CEAZAMet/CEAZA-Snow-Scale/01.Hardware/01.CAD_files/pcb_layout.pdf

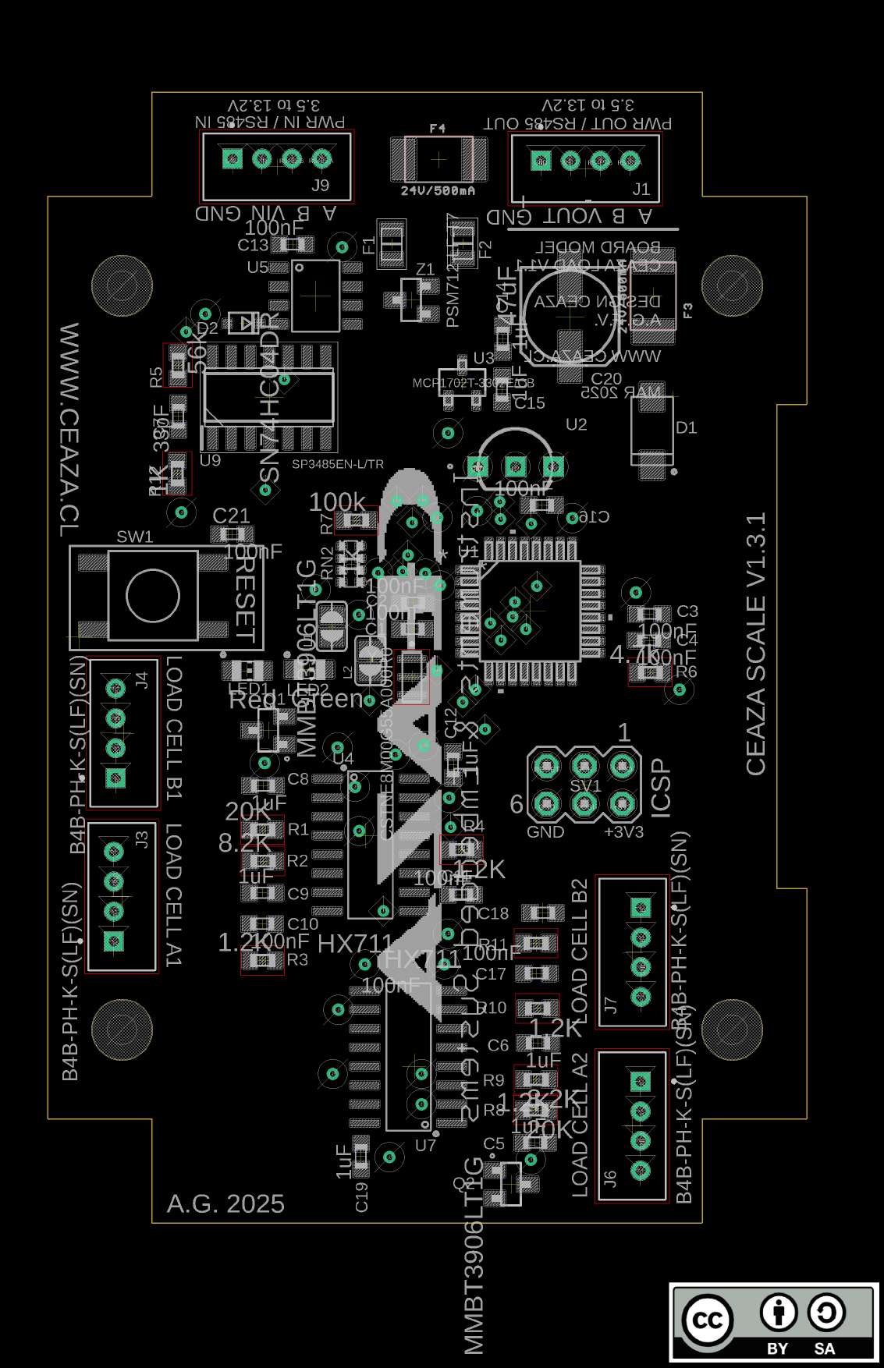
[picture p4: page 1]
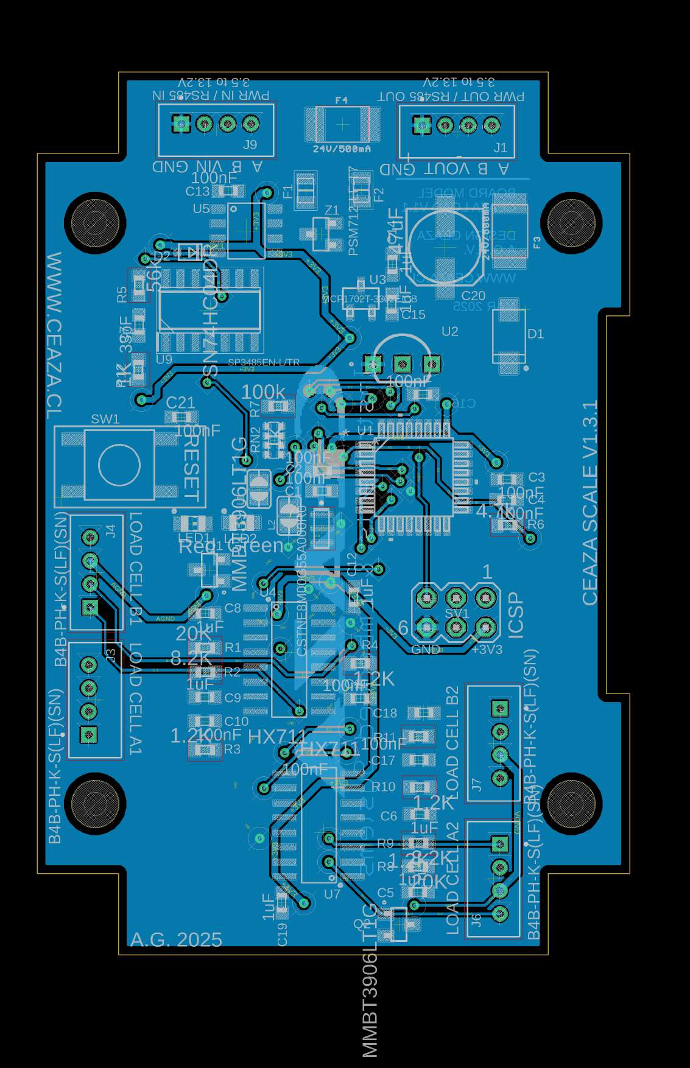
[picture p5: page 2]
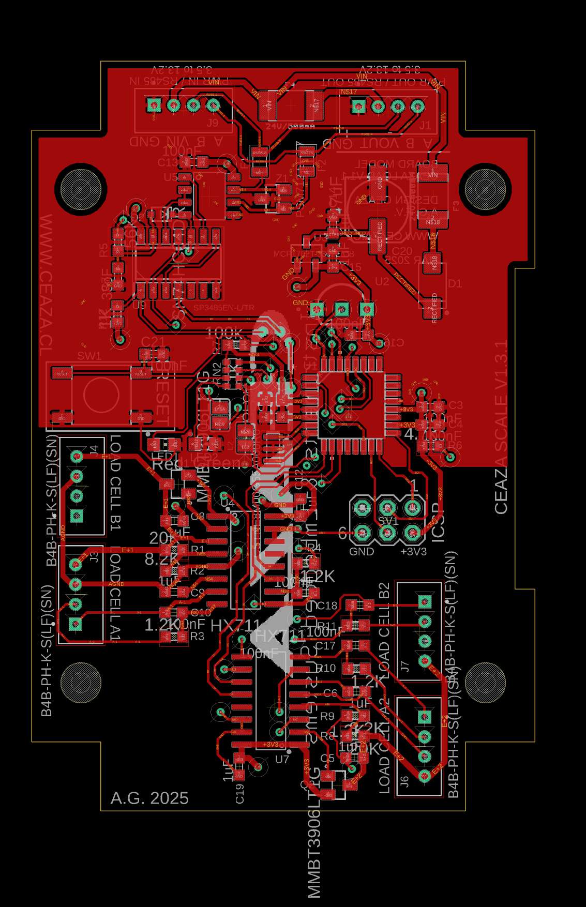
[picture p6: page 3]
