CEAZAMet/CEAZA-Snow-Scale/01.Hardware/01.CAD_files/schematic_snow_scale.pdf

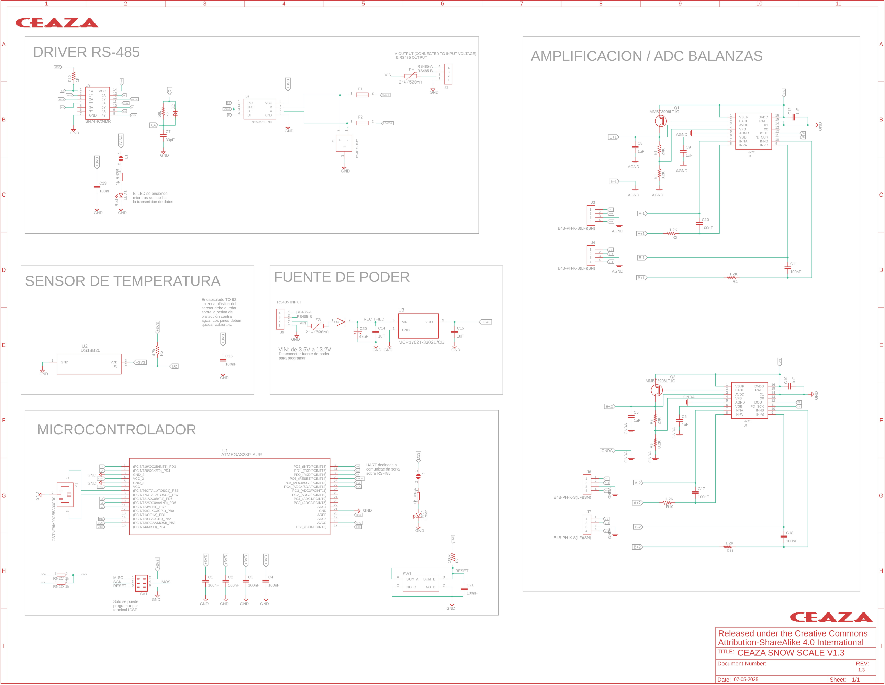
[picture p7: page 1]
