CEAZAMet/CEAZA-Snow-Scale/03.Photos/CEAZA_SNOWSCALE_V1.3_BOTTOM.jpeg

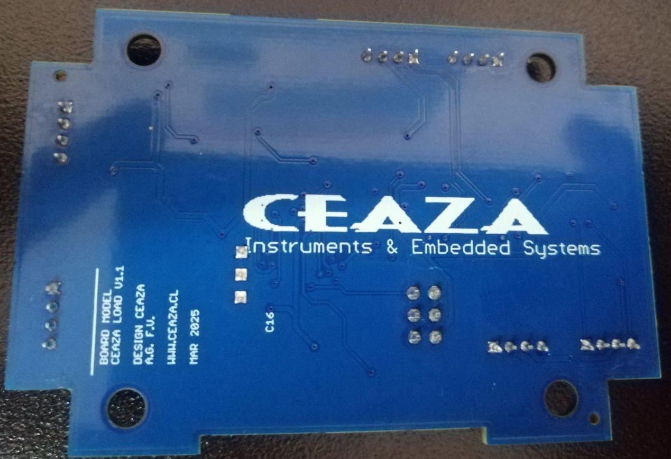
03.Photos/CEAZA_SNOWSCALE_V1.3_BOTTOM.jpeg
