CEAZAMet/CEAZA-Snow-Scale/01.Hardware/02.BOM/BOM_CEAZA_SNOW_SCALE_V1.3.xls

Comment | Designator | Footprint
LITTELFUSE - 0805L010/24YR - Resettable | F1, F2 | FUSC2114X100N
PH Series 4 Position 2 mm Pitch | J1, J9, J3, J4, J6, J7 | JST_B4B-PH-K-S(LF)(SN)
DIODE 75V Independent Type 1.25V@150mA | D2 | SOD323-R
PIN HEADER | SV1 | MA03-2
U1 | SW1 | SW_KH-6X6X5H-STM
1.2K R-US 0603 | R3, R4, R10, R11 | R0603
Multilayer Ceramic Capacitors MLCC - SMD/SMT 100nF 50V 0603 RoHS | C1,C2, C3, C4, C10, C11, C13, C16, C17, C18,C21 | C0603K
1k | R12 | R0603
Resistor Networks & Arrays 1KOhms ±5% 1/16W 0603_x4 RoHS | RN2 | 0603-ARV
CAPACITOR, European symbol | C5, C6, C8, C9, C12, C14, C15, C19 | C0603K
20K | R1, R8 | R0603
Resettable Fuse PTC 24V 500mA | F3, F4 | 1812
33pF | C7 | C0603K
4K7 | R6 | R0603
47uF Decoupling Capacitor | C20 | 153CLV-0605
56k | R5 | R0603
8k2 | R2, R9 | R0603
ATMEL & AVR TQFP-32_7x7x08P RoHS | U1 | 32A
8MHz Ceramic Resonator Built in | Y1 | OSC_CSTNE8M00G55A000R0
DS18B20 | U2 | 21-0248A_MXM
GREEN LEDCHIP-LED0805 | LED2 | CHIP-LED0805
Analog To Digital Converters (ADCs) 24 | U4, U7 | HX711
250 mA Low Quiescent Current LD | U3 | SOT95P255X145-3N
MMBT3906LT1G | Q1, Q2 | SOT23
PSM712-LF-T7 | Z1 | SOT23
RED LEDCHIP-LED0805 | LED1 | CHIP-LED0805
SMA-SS34 | D1 | SMA-SS34
SN74HC04DR, Hex Inverter 5.2mA | U9 | SOIC127P600X175-14N
1.75mm Texas Instruments SN74HC04DR | U5 | SP3485EN-L/TR
100K | R7 | R0603
