CEAZAMet/CEAZA-Snow-Scale/05.Validation_Tests/README.md

# Portable Snow Scale Results

This repository contains the documentation associated with the development and validation of the **Portable Snow Scale**, a project led by **CEAZA** and funded by the **National Agency for Research and Development (ANID)** through the IDEA and R&D programs (Projects **ID22I10074** and **R19F10002**) between 2020 & 2025.

## Contents

- 📊 Experimental test data
- 🧪 Analysis and validation code
- 📄 Technical documentation
- 🖼️ Photos and videos

## Structure

```
/data      - Raw and processed data files  
/code      - Scripts for data analysis and validation  
/docs      - Project documentation and hardware description  
/media     - Visual materials (photos, videos)  
```

## Related Links

- 🔗 Project Website: [https://rednival.ceazamet.cl/](https://rednival.ceazamet.cl/)
- 🔗 Experimental Network (Snow Nodes): [https://www.ceazamet.cl/index.php?pag=mod_mapa&p_cod=nodosnieve](https://www.ceazamet.cl/index.php?pag=mod_mapa&p_cod=nodosnieve)

## License

This project is licensed under the **GNU General Public License v3.0 (GPL-3.0)**.

You may freely use, modify, and distribute this work, provided that any derivative works are also licensed under GPL-3.0 or a compatible version.

See the [`LICENSE`](./LICENSE) file for the full license text, or visit:  
https://www.gnu.org/licenses/gpl-3.0.html
