CEAZAMet/CEAZA-Snow-Scale/05.Validation_Tests/data/README.md

# /data

This folder contains experimental datasets used for validation and analysis of the Portable Snow Scale.
