CEAZAMet/CEAZA-Snow-Scale/05.Validation_Tests/data/BR_IOT.csv

id,I9B8C,dt,2023-03-30T16:15:12Z,vin,13.68,at,24.50,sh,258,sw,0.20,swt,35.44,C,46539
id,I9B8C,dt,2023-03-30T16:25:20Z,vin,13.67,at,25.19,sh,261,sw,0.15,swt,39.81,C,1132
id,I9B8C,dt,2023-03-30T16:35:28Z,vin,13.66,at,25.06,sh,259,sw,0.18,swt,42.94,C,39516
id,I9B8C,dt,2023-03-30T16:45:36Z,vin,13.68,at,25.00,sh,258,sw,0.21,swt,44.56,C,44070
id,I9B8C,dt,2023-03-30T16:55:44Z,vin,13.67,at,24.88,sh,258,sw,0.22,swt,45.06,C,3022
id,I9B8C,dt,2023-03-30T17:16:00Z,vin,13.68,at,22.94,sh,259,sw,0.05,swt,41.69,C,25331
id,I9B8C,dt,2023-03-30T17:26:08Z,vin,13.67,at,22.00,sh,259,sw,-0.11,swt,38.56,C,50198
id,I9B8C,dt,2023-03-30T17:36:16Z,vin,13.68,at,21.75,sh,259,sw,-0.21,swt,35.19,C,14684
id,I9B8C,dt,2023-03-30T17:46:23Z,vin,13.63,at,20.69,sh,259,sw,-0.27,swt,32.56,C,36859
id,I9B8C,dt,2023-03-30T17:56:31Z,vin,13.60,at,20.19,sh,258,sw,-0.31,swt,30.63,C,20906
id,I9B8C,dt,2023-03-30T18:06:39Z,vin,13.60,at,18.56,sh,259,sw,-0.33,swt,29.31,C,4402
id,I9B8C,dt,2023-03-30T18:16:47Z,vin,13.61,at,18.88,sh,259,sw,-0.33,swt,28.50,C,49422
id,I9B8C,dt,2023-03-30T18:37:02Z,vin,13.59,at,18.38,sh,258,sw,-0.34,swt,27.44,C,65097
id,I9B8C,dt,2023-03-30T18:47:10Z,vin,13.57,at,18.38,sh,259,sw,-0.34,swt,27.00,C,1773
id,I9B8C,dt,2023-03-30T18:57:18Z,vin,13.60,at,18.38,sh,260,sw,-0.34,swt,26.56,C,61443
id,I9B8C,dt,2023-03-30T19:07:26Z,vin,13.57,at,18.81,sh,259,sw,-0.34,swt,26.19,C,35102
id,I9B8C,dt,2023-03-30T19:17:33Z,vin,13.55,at,19.00,sh,259,sw,-0.34,swt,26.06,C,42190
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
id,I9B8C,dt,2023-06-10T16:10:24Z,vin,12.75,at,2.06,sh,192,sw,0.78,swt,-0.69,C,43449
id,I9B8C,dt,2023-06-10T16:30:39Z,vin,12.73,at,2.38,sh,192,sw,0.78,swt,-0.69,C,45860
id,I9B8C,dt,2023-06-10T16:40:47Z,vin,12.73,at,2.31,sh,192,sw,0.79,swt,-0.69,C,34084
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
