CEAZAMet/CEAZA-Snow-Scale/05.Validation_Tests/data/Guandacol_Data_FROM_CEAZAMET.csv

Fecha | Guandacol IOT-Temperatura Sensor[°C] | Guandacol IOT-Peso de la Nieve[kg/m²] | Guandacol-Peso de la Nieve[kg/m²] | Guandacol IOT-Altura de Nieve[cm]
01-04-2024 0:00 | 11.78 | -4.92 | -0.33 | 28.2
01-04-2024 1:00 | 11.14 | -4.97 | -0.34 | 27.9
01-04-2024 2:00 | 10.56 | -4.87 | -0.34 | 28.2
01-04-2024 3:00 | 10.12 | -4.85 | -0.36 | 27.4
01-04-2024 4:00 | 9.69 | -4.7 | -0.39 | 28.1
01-04-2024 5:00 | 9.36 | -4.54 | -0.38 | 28.1
01-04-2024 6:00 | 9.06 | -4.49 | -0.39 | 28.3
01-04-2024 7:00 | 8.82 | -4.05 | -0.41 | 29.5
01-04-2024 8:00 | 8.8 | -3.4 | -0.42 | 30.2
01-04-2024 9:00 | 10.58 | 3.19 | -1.63 | 21
01-04-2024 10:00 | 15.69 | 5.04 | -2.08 | 18.1
01-04-2024 11:00 | 18.32 | 4.35 | -2.11 | 16.1
01-04-2024 12:00 | 20.43 | 4.38 | -2.02 | 15
01-04-2024 13:00 | 22.05 | 4.56 | -2.03 | 18.5
01-04-2024 14:00 | 23.3 | 4.44 | -1.95 | 18.5
01-04-2024 15:00 | 23.81 | 3.92 | -1.86 | 20.5
01-04-2024 16:00 | 23.4 | 2.9 | -1.54 | 22.7
01-04-2024 17:00 | 22 | 1.06 | -1.43 | 24.1
01-04-2024 18:00 | 19.58 | -1.75 | -0.92 | 26.1
01-04-2024 19:00 | 17.01 | -3.22 | -0.76 | 25.4
01-04-2024 20:00 | 15.46 | -3.46 | -0.63 | 27.3
01-04-2024 21:00 | 14.26 | -4.06 | -0.31 | 28.1
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
