CEAZAMet/CEAZA-Snow-Scale/05.Validation_Tests/data/tapado_full.csv

Fecha | El Tapado-Altura de Nieve[cm] | El Tapado-Agua equivalente[mm] | El Tapado-Temperatura del Aire[°C] | El Tapado-Peso de la Nieve[kg/m²] | El Tapado-Temperatura Sensor[°C]
01-06-2023 0:00 | 0.59 | 1 | -0.24 | -2.85 | -2
01-06-2023 1:00 | 0.6 | 1 | -0.52 | -3.33 | -2.38
01-06-2023 2:00 | 0.62 | 1 | 0.05 | -3.57 | -2.63
01-06-2023 3:00 | 0.62 | 1 | 0.05 | -3.57 | -2.63
01-06-2023 4:00 | 0.62 | 1 | -0.23 | -3.09 | -3
01-06-2023 5:00
01-06-2023 6:00 | 0.58 | 1 | -0.42 | -2.97 | -3
01-06-2023 7:00 | 0.62 | 2 | -0.96 | -2.74 | -3.13
01-06-2023 8:00 | 0.53 | 2 | 0.68 | 6.78 | -0.94
01-06-2023 9:00 | 0.42 | 2 | 2.7 | 15.1 | 2.06
01-06-2023 10:00 | 0.35 | 2 | 3.78 | 20.33 | 3.88
01-06-2023 11:00 | 0.29 | 2 | 4.48 | 23.78 | 6.13
01-06-2023 12:00 | 0.22 | 2 | 4.62 | 24.85 | 7.69
01-06-2023 13:00 | 0.19 | 2 | 4.95 | 25.21 | 8.94
01-06-2023 14:00 | 0.2 | 2 | 5.11 | 22 | 9.25
01-06-2023 15:00 | 0.14 | 2 | 4.5 | 10.34 | 7.06
01-06-2023 16:00 | 0.06 | 2 | 2.79 | 0.48 | 3.13
01-06-2023 17:00 | 0.1 | 2 | 1.99 | -1.55 | 0.75
01-06-2023 18:00 | 0.28 | 2 | 0.98 | -2.97 | -0.56
01-06-2023 19:00 | 0.39 | 1 | -0.9 | -3.69 | -1.25
01-06-2023 20:00 | 0.47 | 1 | -2.28 | -3.33 | -1.31
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
