CEAZAMet/CEAZA-Snow-Scale/05.Validation_Tests/data/tascadero_full.csv

Fecha | Tascadero Nodo IOT-Altura de Nieve[cm] | Tascadero Nodo IOT-Peso de la Nieve1[kg/m²] | Tascadero Nodo IOT-Peso de la Nieve2[kg/m²] | Tascadero Nodo IOT-Temperatura Sensor1[°C] | Tascadero Nodo IOT-Temperatura Sensor2[°C] | Tascadero Nodo IOT-Temperatura del Aire[°C] | Tascadero-Altura de Nieve[cm] | Tascadero-Peso de la Nieve[kg/m²] | Tascadero-Temperatura del Aire[°C]
01-04-2024 0:00 | -1.7 | 4.72 | 5.06 | 5.34 | 5.54 | 3.16 | -0.8 | 0.68 | 3.48
01-04-2024 1:00 | -1.8 | 4.46 | 6.12 | 4.45 | 4.74 | 2.47 | -0.9 | 0.7 | 3.1
01-04-2024 2:00 | -1 | 4.3 | 6.94 | 3.69 | 4.06 | 2.72 | -1 | 0.71 | 3.22
01-04-2024 3:00 | -2.7 | 4.18 | 7.7 | 2.91 | 3.32 | 2.48 | -1 | 0.72 | 3.18
01-04-2024 4:00 | -2.7 | 3.96 | 8.36 | 2.38 | 2.75 | 2.49 | -0.8 | 0.73 | 2.82
01-04-2024 5:00 | -0.1 | 3.7 | 8.69 | 2.31 | 2.69 | 3.94 | -1.2 | 0.7 | 5.25
01-04-2024 6:00 | 0 | 3.7 | 8.69 | 2.31 | 2.69 | 4 | -0.8 | 0.69 | 4.05
01-04-2024 7:00 | 0 | 3.7 | 8.69 | 2.31 | 2.69 | 4 | -0.8 | 0.67 | 4.61
01-04-2024 8:00 | 1.8 | 2.3 | 9.87 | 2.66 | 2.86 | 9.96 | -0.8 | 0.54 | 8.61
01-04-2024 9:00 | 2.4 | 0.98 | 6.11 | 10.12 | 9.51 | 12.86 | -0.7 | 0.38 | 9.63
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
