CEAZAMet/CEAZA-Snow-Scale/05.Validation_Tests/media/Tapado_Fig_2.png

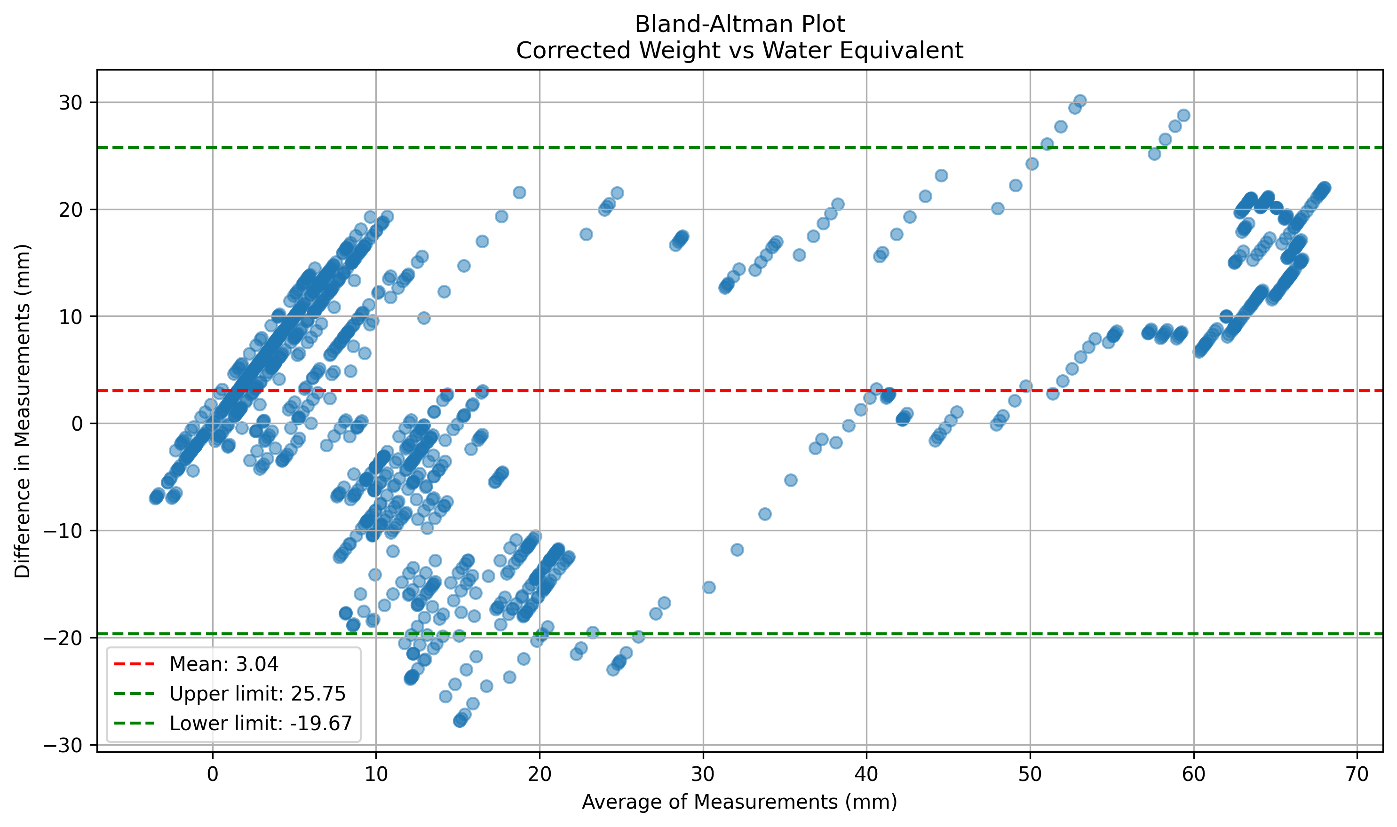
05.Validation_Tests/media/Tapado_Fig_2.png
