CEAZAMet/CEAZA-Snow-Scale/05.Validation_Tests/media/Tascadero_Fig_1.png

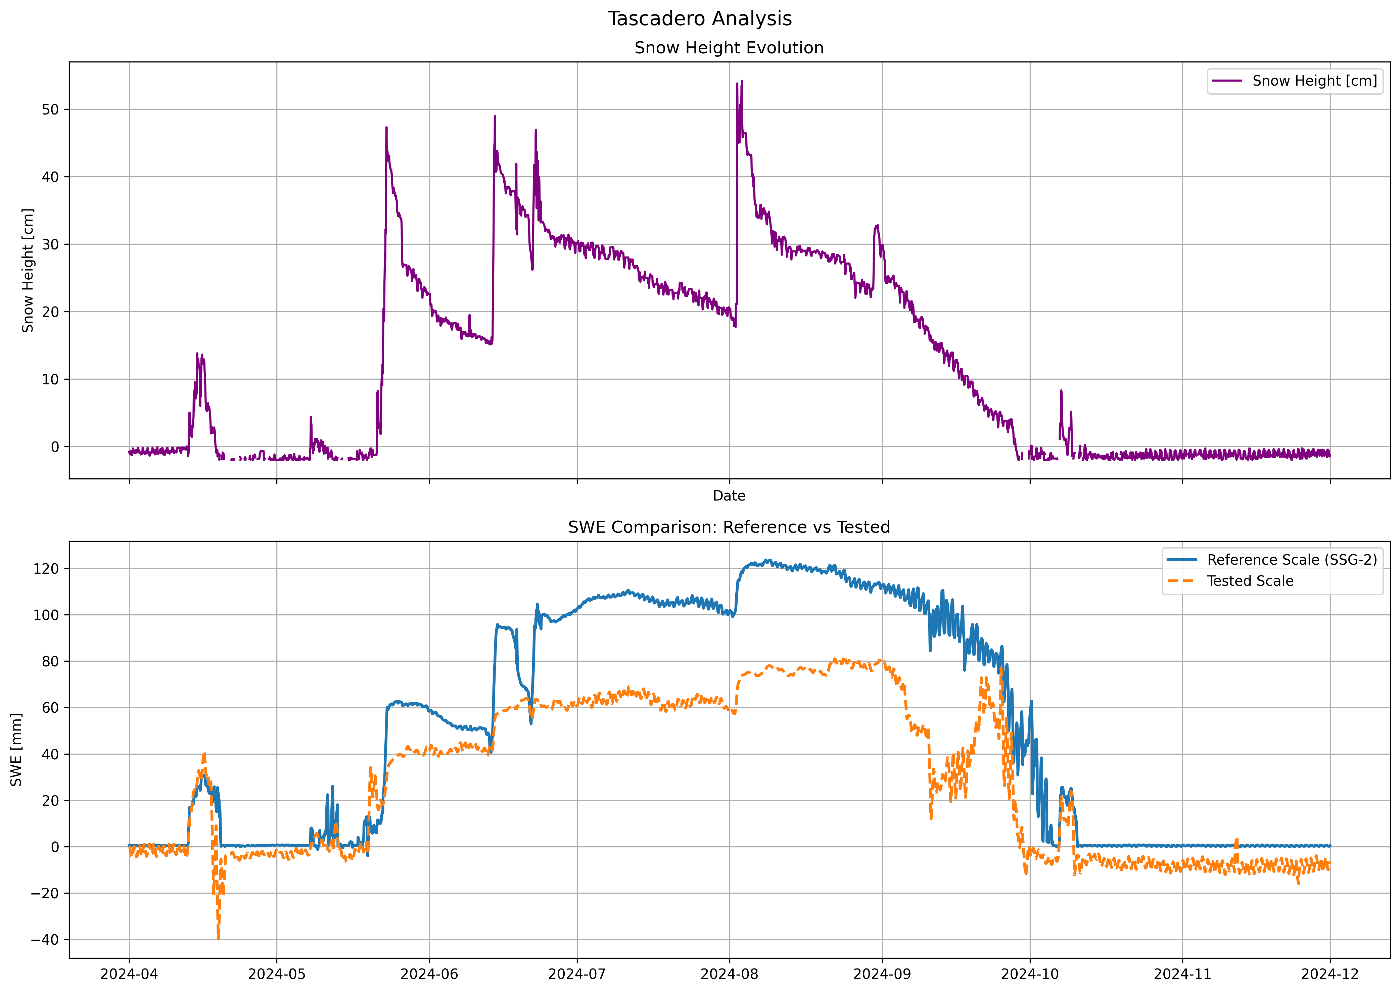
05.Validation_Tests/media/Tascadero_Fig_1.png
