CEAZAMet/CEAZA-Snow-Scale/05.Validation_Tests/media/Tascadero_Fig_2.png

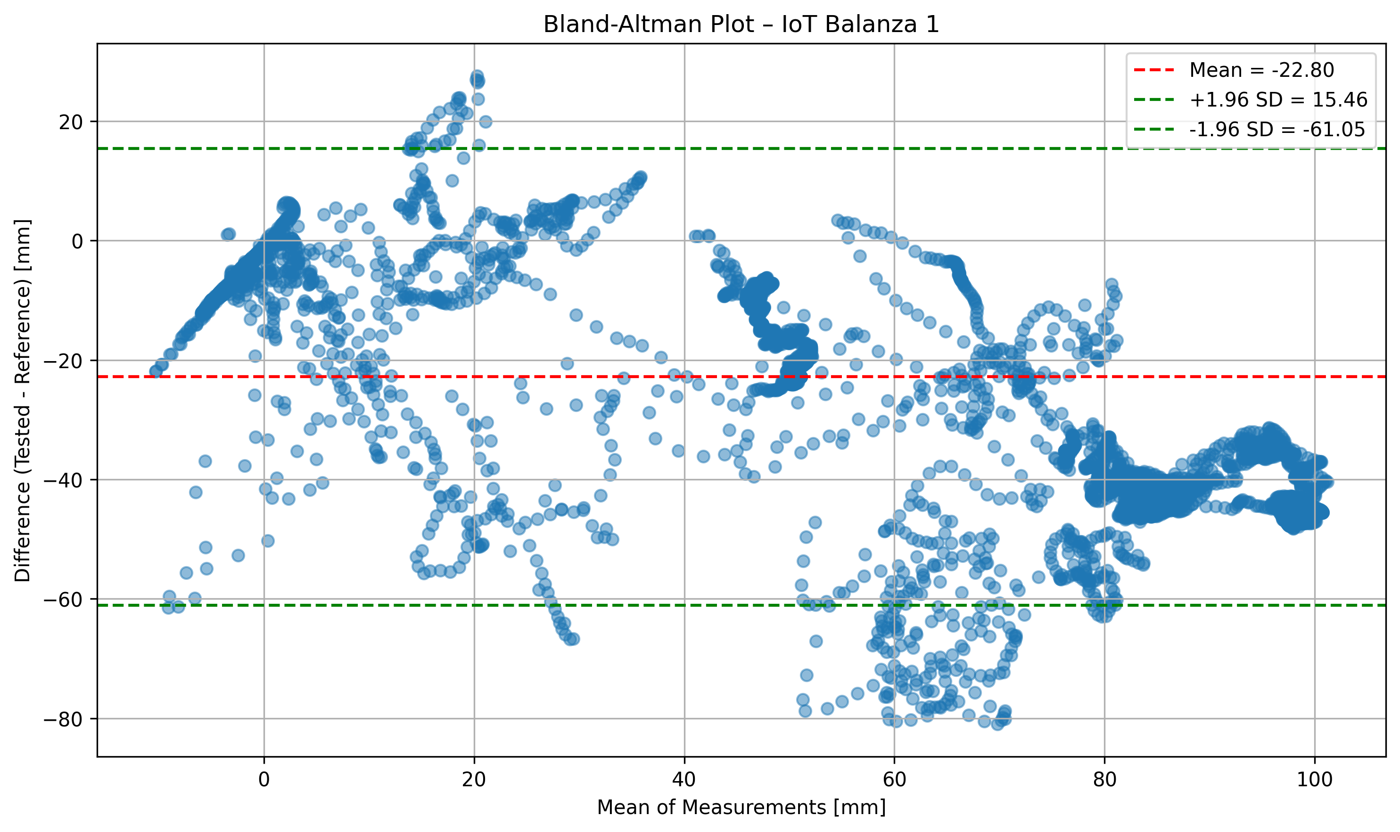
05.Validation_Tests/media/Tascadero_Fig_2.png
