CEAZAMet/CEAZA-Snow-Scale/01.Hardware/01.CAD_files/CEAZA SNOW SCALE V1.3.brd

## EAGLE design 01.Hardware/01.CAD_files/CEAZA SNOW SCALE V1.3.brd (2025-05-15)

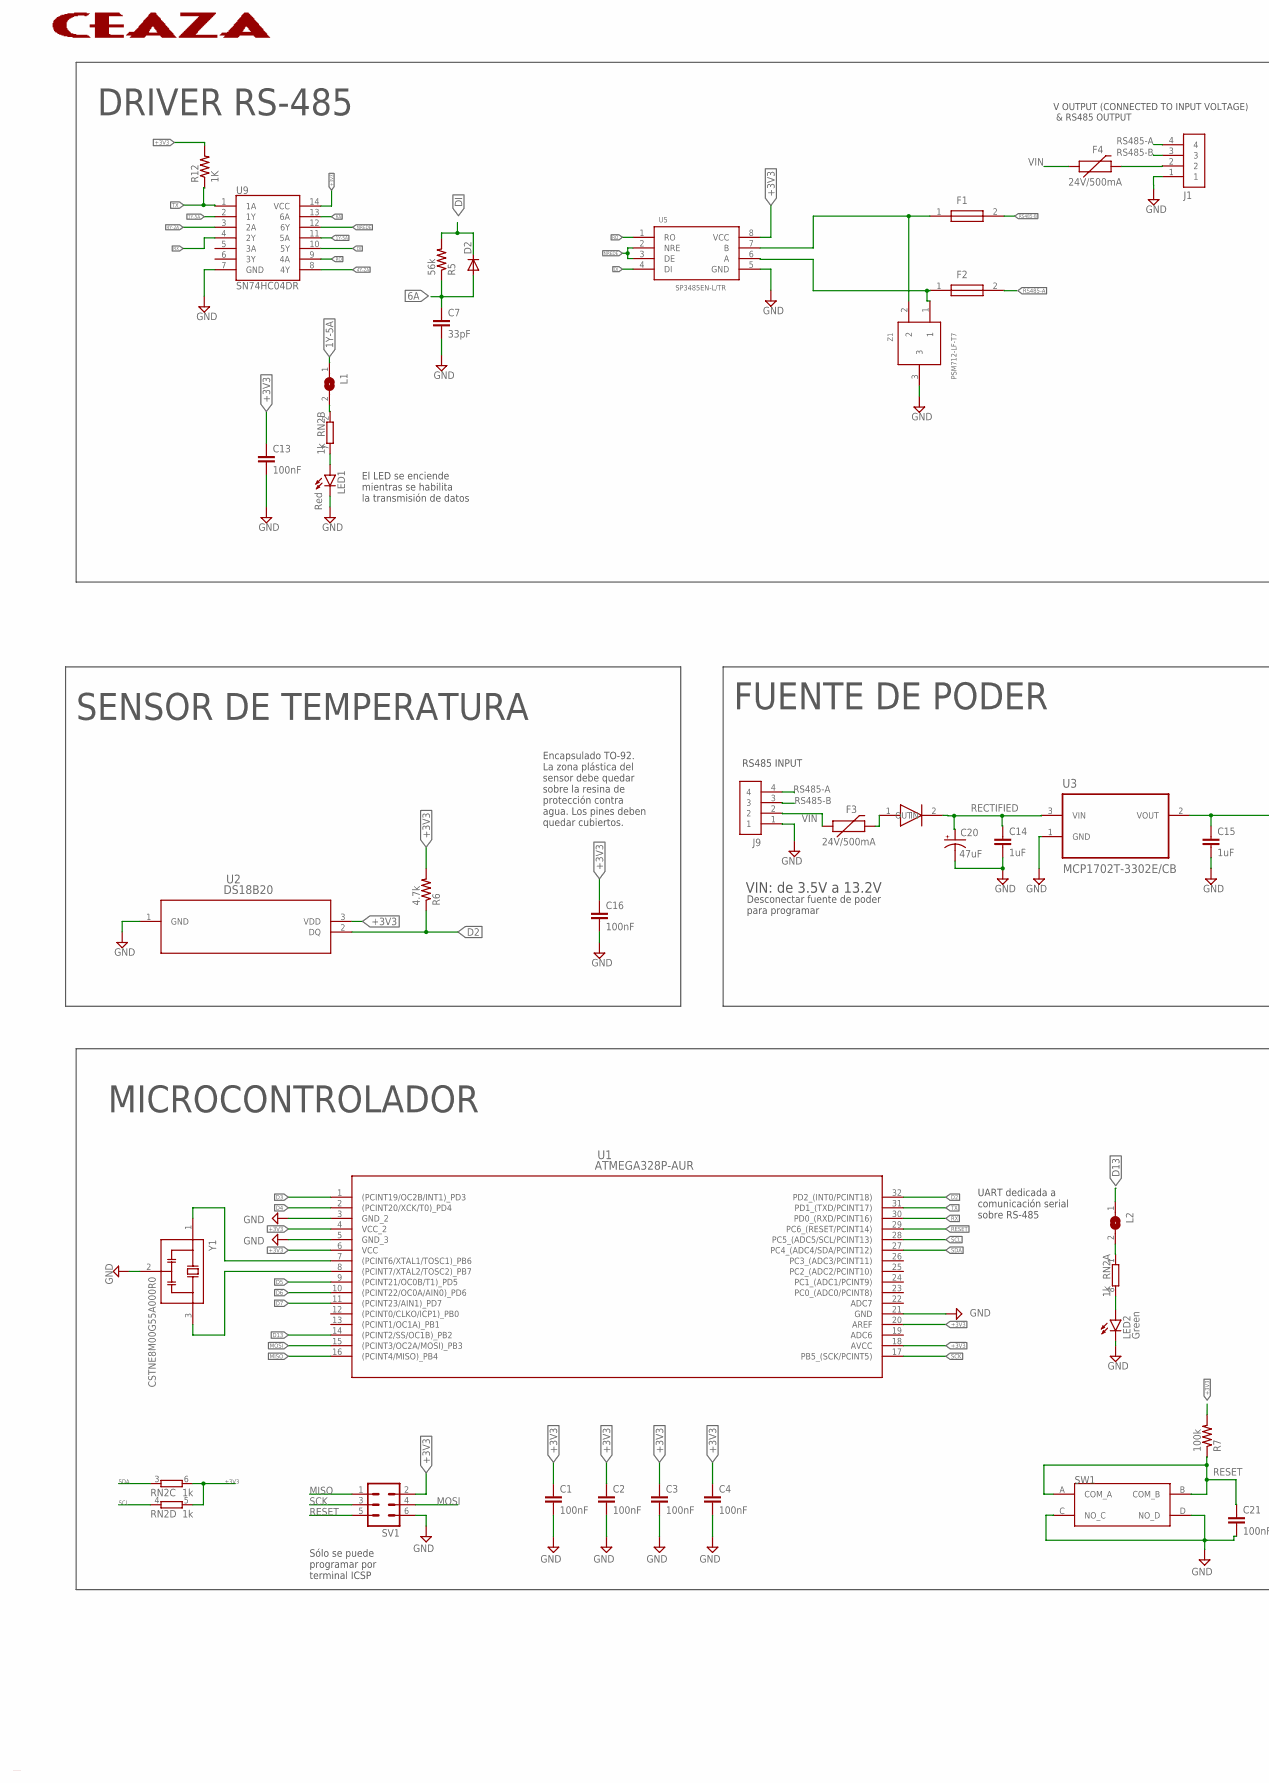
[picture p17: schematic CEAZA SNOW SCALE V1.3.sch, CEAZA SNOW SCALE, part in row 1, column 1]

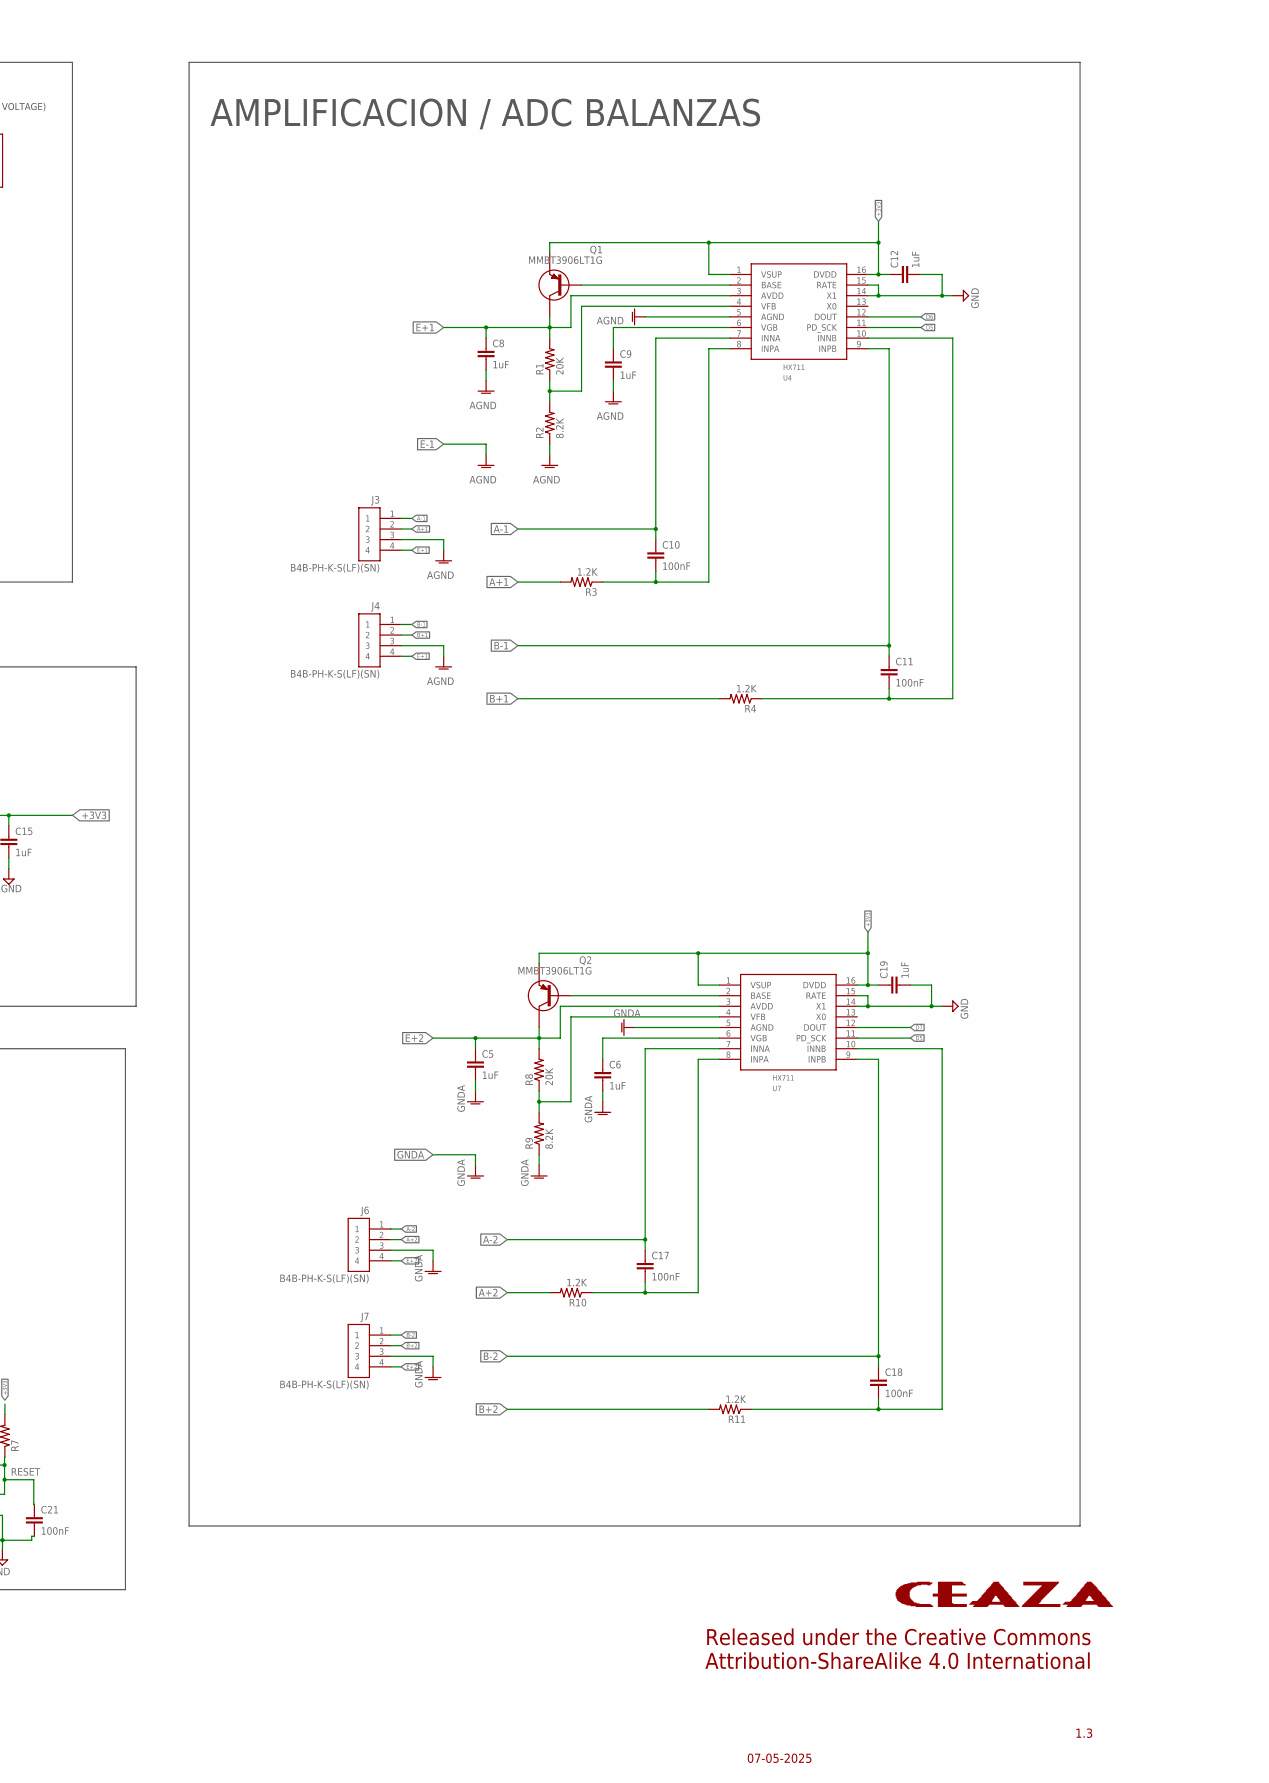
[picture p18: schematic CEAZA SNOW SCALE V1.3.sch, CEAZA SNOW SCALE, part in row 1, column 2]

Parts:
C1, C2, C3, C4, C10, C11, C13, C16, C17, C18, C21: 100nF; C0603K
C5, C6, C8, C9, C12, C14, C15, C19: 1uF; C0603K
C7: 33pF; C0603K
C20: 47uF; 153CLV-0605
D1: SMA-SS34
D2: DIODE-SOD323-R; SOD323-R
F1, F2: 0805L010_24YR; FUSC2114X100N
F3, F4: 24V/500mA; 1812
J1, J3, J4, J6, J7, J9: B4B-PH-K-S(LF)(SN); JST_B4B-PH-K-S(LF)(SN)
L1, L2: SJ
LED1: Red; CHIP-LED0805
LED2: Green; CHIP-LED0805
Q1, Q2: MMBT3906LT1G; SOT23
R1, R8: 20K; R0603
R2, R9: 8.2K; R0603
R3, R4, R10, R11: 1.2K; R0603
R5: 56k; R0603
R6: 4.7k; R0603
R7: 100k; R0603
R12: 1K; R0603
RN2: 1k; 0603-ARV
SV1: MA03-2
SW1: SW_KH-6X6X5H-STM
U1: ATMEGA328P-AUR; 32A
U2: DS18B20; 21-0248A_MXM
U3: MCP1702T-3302E/CB; SOT95P255X145-3N
U4, U7: HX711
U5: SP3485EN-L/TR
U9: SN74HC04DR; SOIC127P600X175-14N
Y1: CSTNE8M00G55A000R0; OSC_CSTNE8M00G55A000R0
Z1: PSM712-LF-T7; SOT23

Connections:
1Y-5A: L1.1, U9.2 (1Y), U9.11 (5A)
4Y-2A: U9.3 (2A), U9.8 (4Y)
6A: C7.1, D2.A, R5.1, U9.13 (6A)
+3V3: C1.1, C2.1, C3.1, C4.1, C12.1, C13.1, C15.1, C16.1, C19.1, Q1.2 (E), Q2.2 (E), R6.2, R7.2, R12.2, RN2.5 (2), RN2.6 (2), SV1.2, U1.4 (VCC_2), U1.6 (VCC), U1.18 (AVCC), U1.20 (AREF), U2.3 (VDD), U3.2 (VOUT), U4.1 (VSUP), U4.16 (DVDD), U5.8 (VCC), U7.1 (VSUP), U7.16 (DVDD), U9.14 (VCC)
A+1: J3.2, R3.2
A+2: J6.2, R10.2
A-1: C10.1, J3.1, U4.7 (INNA)
A-2: C17.1, J6.1, U7.7 (INNA)
AGND: C8.2, C9.2, J3.3, J4.3, R2.1, U4.5 (AGND)
B+1: J4.2, R4.2
B+2: J7.2, R11.2
B-1: C11.1, J4.1, U4.9 (INPB)
B-2: C18.1, J7.1, U7.9 (INPB)
D2: R6.1, U1.32 (PD2_(INT0/PCINT18)), U2.2 (DQ)
D3: U1.1 ((PCINT19/OC2B/INT1)_PD3)
D4: U1.2 ((PCINT20/XCK/T0)_PD4)
D5: U1.9 ((PCINT21/OC0B/T1)_PD5), U4.11 (PD_SCK), U7.11 (PD_SCK)
D6: U1.10 ((PCINT22/OC0A/AIN0)_PD6), U4.12 (DOUT)
D7: U1.11 ((PCINT23/AIN1)_PD7), U7.12 (DOUT)
D13: L2.1, U1.14 ((PCINT2/SS/OC1B)_PB2)
DI: D2.C, R5.2, U5.4 (DI), U9.10 (5Y)
E+1: C8.1, J3.4, J4.4, Q1.3 (C), R1.2, U4.3 (AVDD)
E+2: C5.1, J6.4, J7.4, Q2.3 (C), R8.2, U7.3 (AVDD)
GND: C1.2, C2.2, C3.2, C4.2, C7.2, C12.2, C13.2, C14.2, C15.2, C16.2, C19.2, C20.-, C21.2, J1.1, J9.1, LED1.C, LED2.C, SV1.6, SW1.C (NO_C), SW1.D (NO_D), U1.3 (GND_2), U1.5 (GND_3), U1.21 (GND), U2.1 (GND), U3.1 (GND), U4.14 (X1), U4.15 (RATE), U5.5 (GND), U7.14 (X1), U7.15 (RATE), U9.7 (GND), Y1.2 (GND), Z1.3
GNDA: C5.2, C6.2, J6.3, J7.3, R9.1, U7.5 (AGND)
MISO: SV1.1, U1.16 ((PCINT4/MISO)_PB4)
MOSI: SV1.4, U1.15 ((PCINT3/OC2A/MOSI)_PB3)
unnamed: F2.1, U5.6 (A), Z1.1
unnamed: Q1.1 (B), U4.2 (BASE)
unnamed: LED1.A, RN2.7 (2)
unnamed: C9.1, U4.6 (VGB)
unnamed: R1.1, R2.2, U4.4 (VFB)
unnamed: Q2.1 (B), U7.2 (BASE)
unnamed: C10.2, R3.1, U4.8 (INPA)
unnamed: C11.2, R4.1, U4.10 (INNB)
unnamed: R8.1, R9.2, U7.4 (VFB)
unnamed: U1.7 ((PCINT6/XTAL1/TOSC1)_PB6), Y1.1 (IN)
unnamed: U1.8 ((PCINT7/XTAL2/TOSC2)_PB7), Y1.3 (OUT)
unnamed: LED2.A, RN2.8 (2)
unnamed: C6.1, U7.6 (VGB)
unnamed: C17.2, R10.1, U7.8 (INPA)
unnamed: C18.2, R11.1, U7.10 (INNB)
unnamed: F1.1, U5.7 (B), Z1.2
unnamed: F4.2, J1.2
unnamed: D1.1 (IN), F3.2
unnamed: L1.2, RN2.2 (1)
unnamed: L2.2, RN2.1
NREDE: U5.2 (NRE), U5.3 (DE), U9.12 (6Y)
RECTIFIED: C14.1, C20.+, D1.2 (OUT), U3.3 (VIN)
RESET: C21.1, R7.1, SV1.5, SW1.A (COM_A), SW1.B (COM_B), U1.29 (PC6_(RESET/PCINT14))
RO: U5.1 (RO), U9.9 (4A)
RS485-A: F2.2, J1.4, J9.4
RS485-B: F1.2, J1.3, J9.3
RX: U1.30 (PD0_(RXD/PCINT16)), U9.4 (2Y)
SCK: SV1.3, U1.17 (PB5_(SCK/PCINT5))
SCL: RN2.4 (1), U1.28 (PC5_(ADC5/SCL/PCINT13))
SDA: RN2.3 (1), U1.27 (PC4_(ADC4/SDA/PCINT12))
TX: R12.1, U1.31 (PD1_(TXD/PCINT17)), U9.1 (1A)
VIN: F3.1, F4.1, J9.2

Notes on the sheet:
SENSOR DE TEMPERATURA
AMPLIFICACION / ADC BALANZAS
DRIVER RS-485
FUENTE DE PODER
VIN: de 3.5V a 13.2V
MICROCONTROLADOR
Sólo se puede programar por terminal ICSP
Encapsulado TO-92. La zona plástica del sensor debe quedar sobre la resina de protección contra agua. Los pines deben quedar cubiertos.
UART dedicada a comunicación serial sobre RS-485
Desconectar fuente de poder para programar
El LED se enciende mientras se habilita la transmisión de datos
C:/Users/adria/OneDrive/Imágenes/CEAZA_NOMBRE_COLOR.bmp
RS485 INPUT
V OUTPUT (CONNECTED TO INPUT VOLTAGE) & RS485 OUTPUT
Released under the Creative Commons Attribution-ShareAlike 4.0 International
07-05-2025
1.3

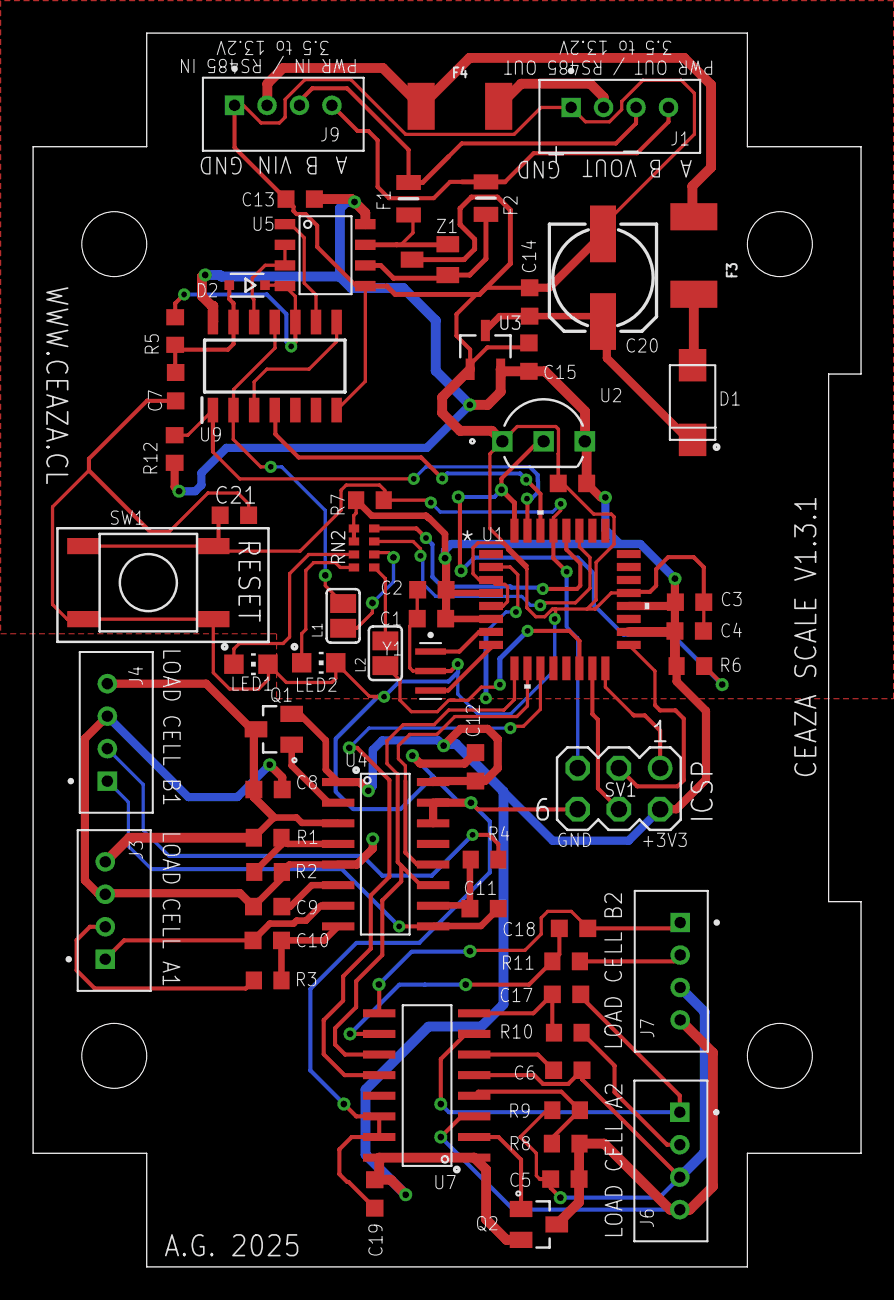
[picture p19: board CEAZA SNOW SCALE V1.3.brd from above]

Board: 2 copper layers, 51.0 x 76.0 mm, 63 parts (0 on the bottom side), 57 nets.
