CEAZAMet/CEAZA-Snow-Scale/(commit log)

2025-05-15 dejar de rastrear description_snow_scale.txt
2025-05-15 Dejar de rastrear carpeta V1.3 y agregarlo al .gitignore
    [CEAZA_PESA_V1.3.brd, CEAZA_PESA_V1.3.sch, ID000-20201127.xlsx, ID001-20201127.xlsx, ID002-20201211.xlsx, ID003-20201211.xlsx, ID004-20201211.xlsx, ID005-20210106.xlsx]
2025-05-15 licencias txt
    [CEAZA_PESA_V1.3.brd, CEAZA_PESA_V1.3.sch, ID000-20201127.xlsx, ID001-20201127.xlsx, ID002-20201211.xlsx, ID003-20201211.xlsx, ID004-20201211.xlsx, ID005-20210106.xlsx]
2025-05-15 eliminar carpetas
    [CEAZA_PESA_V1.3.brd, CEAZA_PESA_V1.3.sch, ID000-20201127.xlsx, ID001-20201127.xlsx, ID002-20201211.xlsx, ID003-20201211.xlsx, ID004-20201211.xlsx, ID005-20210106.xlsx]
2025-05-16 readme hardware schematic
2025-05-19 Readme update12
    [CEAZA SNOW SCALE V1.3.brd, CEAZA SNOW SCALE V1.3.sch]
2025-05-19 Readme update13
    [CEAZA SNOW SCALE V1.3.brd, CEAZA SNOW SCALE V1.3.sch]
2025-05-19 Imported other repository into /other-repo-folder
    [BR_IOT.csv, Guandacol_Data_FROM_CEAZAMET.csv, tapado_full.csv, tascadero_full.csv]
2025-05-19 Rename folder from other-repo-folder to 05.Validation_Tests
    [BR_IOT.csv, Guandacol_Data_FROM_CEAZAMET.csv, tapado_full.csv, tascadero_full.csv]
